Beringusz/Soil_Sensor_project/Docs/irrigation.pdf

## Advanced soil sensing and analysis using 5 pin soil sensor(Model

485)

Fazakas David-Antal

July 12, 2026

## Contents

1 Motivation | 1
2 Theoretical notions and definitions | 2
3 Implementation | 4
4 Algorithmic NPK Calibration Model | 7
5 Data acquisition system | 7
6 Experimental Measurements and Analysis | 11
7 Conclusions and future ideas | 14
References | 15

## 1 Motivation

Agriculture provides the base on which every society is built. Food availability is indisputably the most important resource besides water, which defined how civilizations rose and fell since the beginning of written history. It had so much influence, that the First Agricultural revolution which began around 10000 BCE, influenced human genetics and lifestyle, which changed from one of a hunter-gatherer to a sedentary one. This underlines the importance of agricultural technologies and since the First Agricultural revolution, there have been two more: the Second Agricultural Revolution ,occurring between the 17th and 19th centuries, introduced farming tools, crop rotation and machinery; the Third Agricultural Revolution, also called Green Revolution which happened during the middle of the 20th century and introduced plant breeding, synthetic fertilizers and pesticides. Now, the world entered the age of information, which also sparked a development of related technologies(IoT, AI, advanced measurements) which is called the Fourth Agricultural Revolution. [1]

The development of monitoring and sensing technologies for agricultural applications is a highly active area of research. These developments aim to reduce the human and natural resources used in the agricultural sector, utilizing technologies such as IoT, AI, precision agriculture etc. In this highly dynamic and competitive field, the basis of every measurement is the soil. It is the main factor which influences the quality and quantity of the yield. Thus, monitoring the soil becomes the main objective of every data acquisition system designed to help the people working this sector of the economy.

The main focus of this project is to present a soil monitoring system utilizing the 5 pin soil sensor(Model 485) and provide a mathematical model of calibration for estimating the NPK (Nitrogen, Phosphorus, Potassium) content of the soil using the physical quantities measured by the sensor, which are moisture, electrical conductivity, temperature and PH.

## 2 Theoretical notions and definitions

### 2.1 Moisture measurement

Moisture or water content is one of the most important quantities of the soil. It provides a perfect solvent for different chemical elements, which can be picked up by the crops. There are two different ways of measuring the moisture content of the soil: 1. is the direct method where the water content is measured as a fraction of the weight of the soil(gravimetric method). 2. is the indirect method, which measures another variable that is affected by the amount of soil water, and then it relates the changes of this variable to the changes in soil water content, through physically based or empirical relationships called calibration curves. [2]

θv =

θg · ρsoil

ρwater

(1)

where θv is the volumetric water content of the water and θg is the gravimetric water content, which can be expressed by[3]:
θg =

msoil

mdry soil

× 100% | (2)

Most digital soil sensors, like the one examined in this paper, uses the change in the dielectric permittivity of the soil to determine the volumetric water content:

C =

b · 0 · A
d

(3)

where b is the bulk dielectric permittivity of the examined soil, A is the area covered by the sensor prongs, d is the distance between the anode and cathode prongs and 0 is the dielectric permittivity of free space[4]. Based on this relationship, Topp et al. [5] has derived an empirical relation to calculate the volumetric water content θv of the measured soil, based on the changes in bulk dielectric permittivity b since A, d and 0 are constant and depend on the sensor’s geometric setup or are established physically.

θv = −0.053 + 0.0292b − 5.5 × 10⁻⁴

2

b + 4.3 × 10⁻⁶

3
b

(4)

This equation, also known as the Topp equation, is implemented in the sensor on hardware level, so by reading the appropriate registers, it provides the volumetric water content(or moisture level) of the soil θv directly.

### 2.2 Temperature measurement

The soil’s internal temperature is also a really important physical marker, which determines when do crops begin germinating as it regulates how quickly chemical, physical and biological reactions take place inside the ground. Temperature sensing involves the Thermoelectric effect which means that any change in temperature T influences the resistance R of the sensing element. These types of detectors are called resistive temperature detectors(RTDs). Inside the examined soil sensor, one of the pins is connected to a thermistor, which performs the measurements [4]

A negative temperature coefficient(NTC) thermistor’s resistance decreases as the temperature increases, by the following relation:

RT = Ro · e

β

1

T − 1
T0
(5)

where T is the thermistor temperature, T0 is the calibrating temperature(usually 298.15K), R0 is the resistance at calibrating temperature and β is the material’s characteristic temperature. This change however has to be converted to a temperature reading, utilizing the Steinhart-Hart equation:

1
T

= A + B ln R + C (ln R)

3
(6)

where A, B and C are coefficients tha tdepend on the type and model of thermistor and the temperature range of interest.[6]

Similarly to the soil moisture measurement, this calculation of the temperature from the resistance is done by the hardware of the sensor, meaning that by accessing the registers, the user can directly read the temperature in centigrade.

### 2.3 Electrical Conductivity

Electrical conductivity (EC) is a fundamental physical characteristic of the soil matrix. Unlike metallic conductors where current is carried by free electrons, electrical conduction in soil is primarily ionic. When agricultural nutrients—such as Nitrogen, Phosphorus, and Potassium (NPK)—dissolve in soil moisture, they separate into electrically charged cations and anions. When an alternating current (AC) voltage is applied across the sensor’s prongs, these dissolved ions act as mobile charge carriers. Consequently, the bulk EC serves as a highly reliable, indirect indicator of the concentration of soluble salts and macronutrients actively available to the plants.
To model the apparent electrical conductivity (ECa) of the bulk soil, Archie’s empirical law is widely utilized:

ECa = ασwΦ

m | (7)

where α is an empirical constant related to the soil structure, σw is the electrical conductivity of the porous media solution (typically measured in dS/m or µS/cm), Φ is the volumetric porosity, and m is the cementation exponent [7]. While traditional laboratory methodologies require physically removing a sample to create a soil solution extract, the in-situ RS485 sensor bypasses this by measuring the impedance directly in the ground. The hardware calculates the conductivity utilizing the geometric cell constant (k) of its stainless steel electrodes:

ECt =

k
RT
| (8)

where ECt is the temperature-compensated electrical conductivity and RT is the measured electrical resistance at temperature T. To ensure the accuracy of RT over prolonged deployment, the sensor utilizes a high-frequency AC excitation signal; applying a standard direct current (DC) would cause rapid galvanic corrosion of the prongs and electrolytic polarization of the soil water, invalidating the measurement.

### 2.4 Hydrogen cation concentration(pH)

Traditional measurement of soil pH—defined as the negative base-10 logarithm of hydrogen ion activity (H⁺)—requires a delicate potentiometric glass electrode and a chemical reference half-cell. While highly accurate in laboratory environments, these sensors are fundamentally unsuited for long-term agricultural deployment due to rapid physical degradation, bio-fouling, and severe calibration drift when exposed to abrasive soil matrices.[8]
To achieve rugged, long-term durability, the utilized solid-state sensor array does not measure hydrogen ion concentration directly. Instead, it employs an empirical estimation algorithm based on the previously established bulk electrical conductivity (ECt). In standard agronomic profiles, the concentration of dissolved ionic salts shares a mathematically predictable correlation with the soil’s acid-base equilibrium.
The embedded system calculates the estimated pH utilizing a linear interpolation model, mapping the operational range of electrical conductivity to a baseline agricultural pH scale:

pH = pHmin +

(ECmeasured − ECmin) · (pHmax − pHmin) ECmax − ECmin | (9)

where ECmeasured is the real-time conductivity derived from the AC impedance, and the boundary parameters (min and max) are defined by the manufacturer’s empirical lookup tables for typical soil profiles [4]. While this method sacrifices the absolute chemical precision of a glass electrode, it provides a stable, highly durable relative indicator of soil acidity shifts over time without requiring regular recalibration.

### 2.5 Macronutrient (NPK) Estimation

Nitrogen (N), Phosphorus (P), and Potassium (K) represent the three primary macronutrients required for plant biology, driving vegetative growth, energy transfer, and cellular function, respectively. In traditional agronomic laboratory settings, the absolute concentration of these specific ions (such as NO⁻
3

, P O³⁻
4

, and K⁺) is quantified using highly complex methodologies like mass spectrometry, liquid chromatography, or dedicated Ion-Selective Electrodes (ISEs). However, ISE membranes are highly sensitive to bio-fouling and require frequent chemical recalibration, making them entirely unviable for continuous, maintenance-free, in-situ soil monitoring.

Consequently, the 5-pin solid-state sensor array does not possess miniature laboratories to physically separate and measure individual NPK chemical markers. Instead, it utilizes the previously calculated temperature-compensated bulk electrical conductivity (ECt) as a foundational proxy. Because agricultural fertilizers are predominantly composed of soluble ionic salts, a rise in the total concentration of these dissolved macronutrients triggers a proportional increase in the soil’s bulk conductivity.

The sensor’s internal microcontroller employs a deterministic, empirical partitioning algorithm. It maps the total ionic conductivity to individual N, P, and K values (measured in mg/kg) using pre-calibrated proportional coefficients derived from standard agricultural soil profiles:

Cnutrient = γnutrient · ECt + βnutrient | (10)

where Cnutrient represents the estimated concentration of a specific macronutrient (Nitrogen, Phosphorus, or Potassium), γnutrient is the empirically derived scaling factor for that specific ion in typical fertilized soils, and βnutrient is the baseline offset [4].

While this mathematical model cannot detect specific nutrient deficiencies in highly imbalanced soils—as it cannot distinguish between individual ion species—it provides a highly reliable, real-time indicator of overall fertilizer retention and depletion trends. By linking the AC impedance of the soil directly to macronutrient availability, the system offers actionable data for smart irrigation and automated fertilization systems without the inherent fragility of chemical probes.

## 3 Implementation

### 3.1 Hardware Architecture

### 3.1.1 Microcontroller (ATmega328P)

The core processing unit for this data acquisition system is the Arduino Uno Rev3 development board, which houses the Microchip ATmega328P, an 8-bit AVR RISC-based microcontroller. The microcontroller operates at a system clock frequency (fclk) of 16 MHz, utilizing an external quartz crystal oscillator [9]. This specific clock speed is highly critical for the precise timing required to calculate the UART baud rate generation registers (UBRR0H and UBRR0L) for Modbus communication.

The ATmega328P features 14 digital input/output pins and 6 analog inputs. For this implementation, the digital pins were mapped directly via hardware registers (such as DDRD and PORTD) to optimize execution speed and eliminate the overhead of standard abstraction libraries. Crucially, digital pins 0 (RX) and 1 (TX) were utilized to tap directly into the microcontroller’s hardware Universal Synchronous and Asynchronous Receiver-Transmitter (USART) to handle the Modbus RTU byte frames.

### 3.1.2 Industrial Soil Sensor (Model 485)

The physical data acquisition is performed by an industrial-grade 5-pin soil sensor array, utilizing a ruggedized epoxy resin casing and austenitic stainless steel prongs to ensure long-term survivability in abrasive and moist soil environments. The sensor operates on a 12V DC power supply, isolated from the microcontroller’s 5V logic rail. Data is packaged and transmitted using the Modbus RTU protocol over an RS485 physical layer, allowing for robust, noiseimmune communication over long cable runs [4].

### 3.1.3 RS485 to TTL Transceiver (MAX485)

Because the ATmega328P operates using 5V single-ended TTL logic, it is physically incompatible with the industrial RS485 standard utilized by the soil sensor. To bridge this hardware gap, a MAX485 transceiver module was integrated into the circuit [10].

The RS485 standard uses differential signaling across two wires (A and B). When a bit is transmitted, the MAX485 module converts the single-ended 5V UART signal from the microcontroller into a differential voltage across the A and B lines. This differential approach makes the communication highly immune to common-mode electromagnetic interference (EMI). The module operates in half-duplex mode, meaning the same two wires are used for both requesting data from the sensor and receiving the 19-byte data payloads.

### 3.1.4 Liquid Crystal Display (1602A)

Real-time data visualization is achieved using a standard 1602A Liquid Crystal Display (LCD), which features a 16-column by 2-row character matrix. The display is driven by the industry-standard HD44780 controller [11]. To conserve the limited GPIO pins on the microcontroller, the LCD was wired in 4-bit operation mode, utilizing digital pins 7 through 12 for the Register Select (RS), Enable (E), and the four high-order data bus lines (D4-D7). The UI relies on a hardware-debounced tactile pushbutton connected to Port D4, triggering a state-machine that cycles the LCD through four dedicated data screens.

### 3.2 Setup architecture

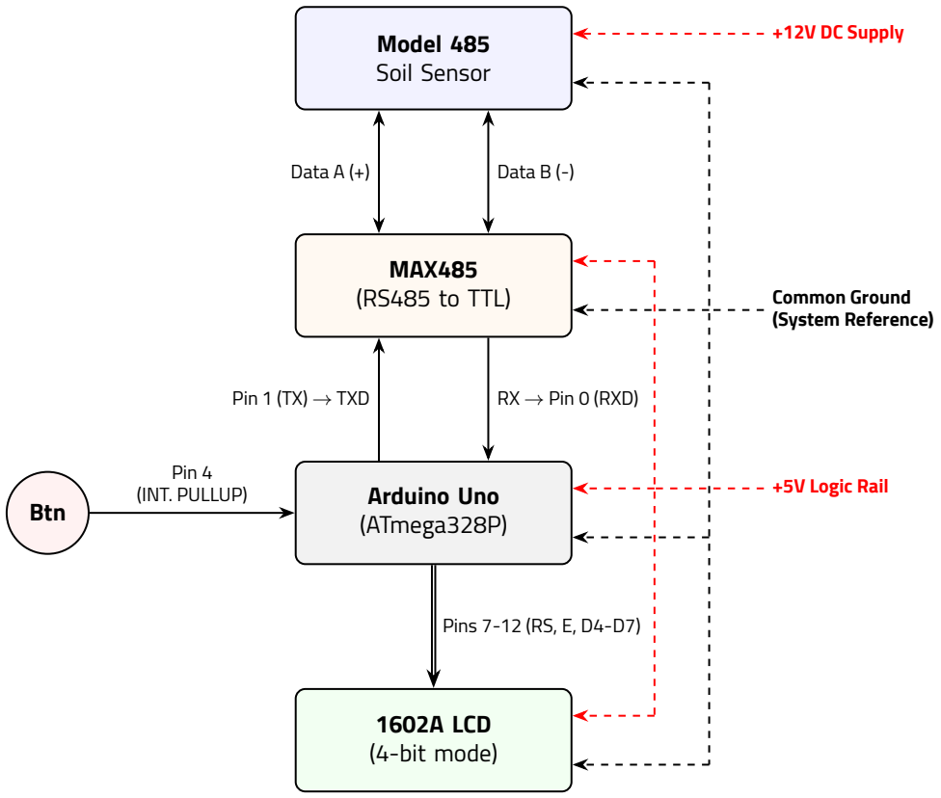
[picture p5: figure]
Model 485 Soil Sensor; MAX485 (RS485 to TTL); Arduino Uno (ATmega328P); 1602A LCD (4-bit mode); Btn; Data A (+); Data B (-); Pin 1 (TX) → TXD; RX → Pin 0 (RXD); Pins 7-12 (RS, E, D4-D7); Pin 4 (INT. PULLUP); +12V DC Supply; +5V Logic Rail; Common Ground (System Reference)

Figure 1: Vertical system architecture diagram.

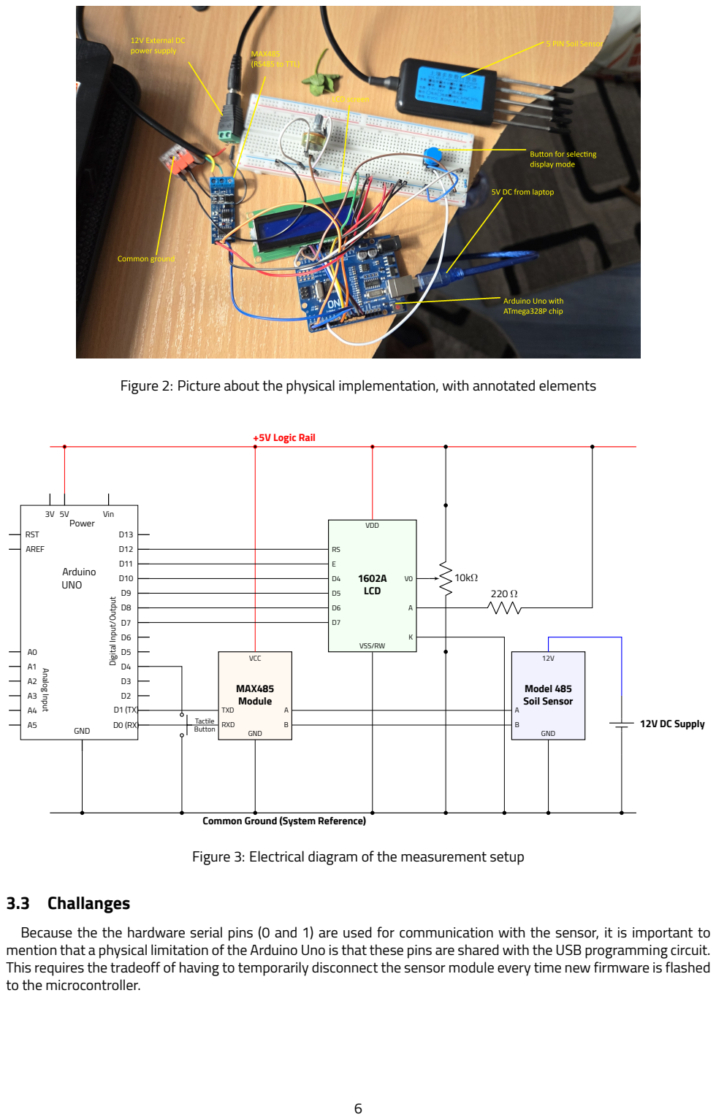
[picture p6: page 6]

Figure 2: Picture about the physical implementation, with annotated elements

Common Ground (System Reference)

Figure 3: Electrical diagram of the measurement setup

Because the the hardware serial pins (0 and 1) are used for communication with the sensor, it is important to
mention that a physical limitation of the Arduino Uno is that these pins are shared with the USB programming circuit.
This requires the tradeoff of having to temporarily disconnect the sensor module every time new firmware is flashed
to the microcontroller.

## 4 Algorithmic NPK Calibration Model

### 4.1 Limitations of Factory Estimation

As established in previous sections, the solid-state sensor does not measure specific N, P, and K ions via selective membranes. The manufacturer’s internal firmware simply applies a static, linear multiplier to the raw electrical conductivity to output an estimated nutrient profile. However, this factory calibration introduces significant error in dynamic field conditions because it treats the soil as a static medium. In reality, the apparent bulk conductivity (ECa) is highly transient; it is artificially inflated by high temperatures (due to increased ionic mobility) and artificially depressed by low moisture (due to the severing of aqueous conductive pathways in the soil pores).

### 4.2 Temperature and Moisture Compensation Algorithm

To calculate a highly accurate, site-specific NPK estimation locally on the ATmega328P, the raw telemetry data must first be standardized. The initial step of the proposed algorithm neutralizes the thermal variance by calculating the Standardized Electrical Conductivity at 25◦C (EC25). This is achieved utilizing the standard agronomic compensation coefficient (α ≈ 0.019◦C

−1
), an internationally recognized conversion factor for agricultural soil matrices [7]:

EC25 =

ECt
1 + α(T − 25) | (11)

where ECt is the raw conductivity measured by the hardware and T is the measured internal soil temperature in Celsius.

Following thermal standardization, the algorithm must account for the diluting or concentrating effect of the volumetric water content (θv). Rather than relying on the generalized factory lookup table, a Multiple Linear Regression (MLR) calibration model is proposed to map the compensated variables directly to a composite Macronutrient Index

(Nidx):

Nidx = β0 + β1(EC25) + β2(θv) + β3(EC25 · θv) | (12)

In this model, β0 represents the baseline intercept (the inherent non-nutrient conductivity of the soil matrix), while β1 and β2 are empirically derived weighting coefficients for the standardized conductivity and moisture, respectively. The interaction term (EC25 ·θv) mathematically corrects for the non-linear relationship between ion dilution and pore saturation. This multivariate algorithmic approach closely aligns with modern precision agriculture methodologies for in-situ macronutrient modeling [12, 13].

By extracting the raw EC, Temperature, and Moisture byte frames via Modbus RTU and executing this multivariate compensation directly on the microcontroller, the system bypasses the flawed factory estimations. This yields a mathematically robust, temperature-immune nutrient profile suitable for smart irrigation systems.

## 5 Data acquisition system

### 5.1 Hardware functionality

The physical data acquisition pipeline begins at the 5-pin soil sensor array, which operates on an isolated 12V DC supply. When polled, the sensor transmits its localized environmental readings utilizing the RS485 industrial communication standard. This physical layer relies on differential voltage signaling across two dedicated wires (Data A and Data B), providing robust immunity to common-mode electromagnetic interference (EMI) typically encountered over long agricultural cable runs.

Because the core ATmega328P microcontroller operates on 5V single-ended TTL logic, it cannot interface directly with the sensor’s differential output. The MAX485 transceiver module serves as the critical hardware bridge in this pipeline. Operating in a half-duplex configuration, the transceiver steps the differential pulses from the soil sensor down to the standard 0V to 5V logic levels required by the Arduino’s hardware Universal Asynchronous Receiver-Transmitter (UART) receiving pin (RX/D0). Conversely, it translates the Arduino’s outbound transmission pulses (TX/D1) back into high-voltage differential signals to request new data from the sensor node.

Once the microcontroller receives the incoming TTL bitstream, the physical output layer is engaged. The ATmega328P routes the data to a 1602A Liquid Crystal Display, utilizing a 4-bit parallel GPIO bus mapped to digital pins 7 through 12 to conserve available connections. To navigate the visualized data screens, a tactile push-button is wired to digital pin 4. To minimize external component count, this input takes advantage of the ATmega328P’s internal hardware pull-up resistor; pressing the button physically bridges the pin to the system’s common ground, creating a distinct voltage drop that the hardware registers as a state change.

### 5.2 Software functionality

The system firmware was developed utilizing C/C++ and compiled via the AVR-GCC toolchain. To minimize processing overhead and ensure deterministic execution, standard abstraction libraries for communication were bypassed. Instead, the ATmega328P’s internal registers (such as UBRR0H, UCSR0B, and UDR0) were manipulated directly to establish a hardware-level Universal Synchronous and Asynchronous Receiver-Transmitter (USART) link at a baud rate of 9600 bps.

The core execution loop relies on a non-blocking, interrupt-free timing architecture. Utilizing the system’s millisecond timer, the firmware polls the soil sensor at a strict 3000-millisecond interval. Simultaneously, it continuously evaluates the state of the digital input pin connected to the tactile interface. A 50-millisecond software debounce algorithm is implemented to filter mechanical switch bounce, ensuring clean state transitions for the user interface without freezing the microcontroller’s execution cycle.

Data acquisition is handled via a custom Modbus RTU implementation. The firmware constructs an 8-byte request frame (targeting node 0x02 and invoking function code 0x03 to read holding registers). Before transmission, the array is passed through a custom Cyclic Redundancy Check (CRC-16) function, which utilizes bitwise XOR operations and right-shifts to compute a Modbus-compliant checksum. Upon receiving the 19-byte response from the sensor, the firmware verifies the integrity of the payload. If the transmission is validated, the raw hexadecimal data is isolated via bitwise left-shifts and cast into standardized floating-point variables.

Once the raw parameters are buffered in the system memory, the firmware executes the algorithmic compensation model. The raw electrical conductivity (ECt) is processed through the thermal standardization algorithm to yield EC25. Subsequently, this thermally immune variable is passed into the Multiple Linear Regression (MLR) matrix alongside the volumetric water content (θv) to compute the localized NPK macronutrient indices.

Finally, a dedicated display function routes the processed data to the 1602A LCD. A switch-case state machine, driven by the debounced hardware button, dictates the active visualization tier: raw physical metrics (Temperature and Moisture), chemical parameters (EC and pH), the factory-estimated Modbus NPK profile, or the locally computed algorithmic NPK indices.
1 #include <LiquidCrystal.h>

2
3 | LiquidCrystal lcd(7, 8, 9, 10, 11, 12);
4 | //for imitating modbus library
5 | #define BAUD 9600 //this is the baud rate
6 | #define MYUBRR (16000000 UL/16/BAUD -1)//16Mz / 16/ (BAUD - 1)

7
8 | // offset values
9 | float tempOffset = 0.0;
10 | float moistureOffset = 0.0;
11 | float ecMultiplier = 1.0;
12 | int ecMin = 200, ecMax = 2000;
13 | int phMin = 60, phMax = 75;

14
15 | //Calibration coeff for NPK
16 | const float beta0 = 5.0; | //Baseline intercept
17 | const float beta1 = 0.04; //EC weight
18 | const float beta2 = 0.5; | //Moisture weight
19 | const float beta3 = 0.001; //Interaction weight (EC * Moisture)

20
21 | //vars for storing data , initialized
22 | float currentTemp = 0.0;
23 | float currentMoisture = 0.0;
24 | float currentEc = 0.0;
25 | float currentPh = 0.0;

26
27 //Factory NPK

28 | uint16_t currentN = 0;
29 | uint16_t currentP = 0;
30 | uint16_t currentK = 0;

31
32 | //Custom NPK
33 | float calcN = 0.0;
34 | float calcP = 0.0;
35 | float calcK = 0.0;

36
37 | //for LCD display
38 | int displayState = 0;
39 | int maxStates = 4;
40 | unsigned long lastSensorRead = 0;
41 | const unsigned long readInterval = 3000;

42
43 | //button debouncing variables
44 | int buttonState = HIGH;
45 | bool lastButtonState = HIGH;
46 | unsigned long lastDebounceTime = 0;
47 | const unsigned long debounceDelay = 50;

48
49 | //UART init function
50 | void UART_Init(unsigned int ubrr)
51 | {
52 | UBRR0H = (unsigned char)(ubrr >> 8);
53 | UBRR0L = (unsigned char)ubrr;
54 | UCSR0B = (1 << RXEN0) | (1 << TXEN0);
55 | UCSR0C = (1 << UCSZ01) | (1 << UCSZ00);
56 | }

57
58 | //wait until operation is complete , then send the data
59 | void UART_Transmit(unsigned char data)
60 | {
61 | while (!( UCSR0A & (1 << UDRE0)));
62 | UDR0 = data;
63 | }

64
65 | //wait until operation is complete , then receive the data and return it
66 | int UART_Receive(uint16_t timeout_ms)
67 | {
68 | uint32_t start = millis();
69 | while (!( UCSR0A & (1 << RXC0)))
70 | {
71 | if (millis() - start > timeout_ms) return -1;
72 | }
73 | return UDR0;
74 | }

75
76 | //cyclic redundancy check CRC16 for Modbus variant
77 | uint16_t ModbusCRC16(uint8_t *buf , uint8_t len)
78 | {
79 | uint16_t crc = 0xFFFF;
80 | for (uint8_t pos = 0; pos < len; pos++)
81 | {
82 | crc ^= (uint16_t)buf[pos];
83 | for (int i = 8; i != 0; i--)
84 | {
85 | if ((crc & 0x0001) != 0)
86 | {
87 | crc >>= 1;
88 | crc ^= 0xA001;
89 | } else
90 | {
91 | crc >>= 1;
92 | }
93 | }
94 | }
95 | return crc;
96 | }

97
98 | void setup()
99 | {
100 | //read button state
101 | DDRD &= ~(1 << DDD4);
102 | PORTD |= (1 << PORTD4);

104 | //uart init
105 | UART_Init(MYUBRR);
106 | //lcd init
107 | lcd.begin(16, 2);
108 | lcd.clear();
109 | lcd.setCursor(0, 0);
110 | lcd.print("System Booting..");

111
112 | delay (2000);
113 | updateDisplay ();
114 | }

115
116 | void loop() {
117 | // button debouncing
118 | bool isPressed = !(PIND & (1 << PIND4));
119 | bool reading = isPressed ? LOW : HIGH;

120
121 | if (reading != lastButtonState) {
122 | lastDebounceTime = millis();
123 | }

124
125 | //update display , if button is pressed and released
126 | if ((millis() - lastDebounceTime) > debounceDelay) {
127 | if (reading != buttonState) {
128 | buttonState = reading;
129 | if (buttonState == LOW) {
130 | displayState ++;
131 | if (displayState >= maxStates) displayState = 0;
132 | updateDisplay ();
133 | }
134 | }
135 | }

136
137 lastButtonState = reading;

138
139 | if (millis() - lastSensorRead >= readInterval) {
140 | lastSensorRead = millis();
141 | readSensor ();
142 | }
143 | }

144
145 | //reading the sensor from 0x02 addr
146 | void readSensor ()
147 | {
148 | uint8_t requestFrame [8] = {0x02 , 0x03 , 0x00 , 0x00 , 0x00 , 0x07 , 0x00 , 0x00};
149 | uint16_t crc = ModbusCRC16(requestFrame , 6);
150 | requestFrame [6] = crc & 0xFF;
151 | requestFrame [7] = (crc >> 8) & 0xFF;

152
153 | while (UCSR0A & (1 << RXC0))
154 | {
155 | char dump = UDR0;
156 | }

157
158 | for (int i = 0; i < 8; i++)
159 | {
160 | UART_Transmit(requestFrame[i]);
161 | }

162
163 | uint8_t response [19];
164 | bool success = true;

165
166 | for (int i = 0; i < 19; i++)
167 | {
168 | int incomingByte = UART_Receive (200);
169 | if (incomingByte == -1) {
170 | success = false;
171 | break;
172 | }
173 | response[i] = (uint8_t)incomingByte;
174 | }

175
176 | if (success && response [0] == 0x02 && response [1] == 0x03)
177 | {
178 | uint16_t rawTemp | = (response [3] << 8) | response [4];
179 | uint16_t rawMoisture = (response [5] << 8) | response [6];

180 | uint16_t rawEc | = (response [7] << 8) | response [8];
181 | uint16_t rawN | = (response [11] << 8) | response [12];
182 | uint16_t rawP | = (response [13] << 8) | response [14];
183 | uint16_t rawK | = (response [15] << 8) | response [16];

184
185 | currentTemp = (( int16_t)rawTemp / 10.0) + tempOffset;
186 | currentMoisture = (rawMoisture / 10.0) + moistureOffset;
187 | currentEc = rawEc * ecMultiplier;

188
189 | int constrainedEc = constrain(currentEc , ecMin , ecMax);
190 | currentPh = map(constrainedEc , ecMin , ecMax , phMin , phMax) / 10.0;

191
192 | currentN = rawN;
193 | currentP = rawP;
194 | currentK = rawK;

195
196 | //calculate Standardized EC at 25C (alpha = 0.019)
197 | float ec25 = currentEc / (1.0 + 0.019 * (currentTemp - 25.0));

198
199 | //apply Multiple Linear Regression for Nitrogen
200 | calcN = beta0 + (beta1 * ec25) + (beta2 * currentMoisture) + (beta3 * ec25 * currentMoisture);

201
202 | //proportional Estimation for P and K (Typical Agronomic Ratios)
203 | calcP = calcN * 0.25; //just an example
204 | calcK = calcN * 0.60; //just an example

205
206 | updateDisplay ();
207 | }
208 | }

209
210 | //LCD setup for display
211 | void updateDisplay () {
212 | lcd.clear();
213 | switch (displayState) {
214 | case 0:
215 | lcd.setCursor(0, 0);
216 | lcd.print("Temp: "); lcd.print(currentTemp , 1); lcd.print(" C");
217 | lcd.setCursor(0, 1);
218 | lcd.print("Moist: "); lcd.print(currentMoisture , 1); lcd.print(" %");
219 | break;
220 | case 1:
221 | lcd.setCursor(0, 0);
222 | lcd.print("EC: "); lcd.print((int)currentEc); lcd.print(" us/cm");
223 | lcd.setCursor(0, 1);
224 | lcd.print("pH: "); lcd.print(currentPh , 1);
225 | break;
226 | case 2:
227 | //Factory Estimated NPK
228 | lcd.setCursor(0, 0);
229 | lcd.print("fN:"); lcd.print(currentN);
230 | lcd.print(" fP:"); lcd.print(currentP);
231 | lcd.setCursor(0, 1);
232 | lcd.print("fK:"); lcd.print(currentK); lcd.print(" mg/kg");
233 | break;
234 | case 3:
235 | //Custom Algorithmic NPK
236 | lcd.setCursor(0, 0);
237 | lcd.print("cN:"); lcd.print((int)calcN);
238 | lcd.print(" cP:"); lcd.print((int)calcP);
239 | lcd.setCursor(0, 1);
240 | lcd.print("cK:"); lcd.print((int)calcK); lcd.print(" mg/kg");
241 | break;
242 | }
243 | }
| | Listing 1: Firmware implementing local algorithmic NPK compensation.

## 6 Experimental Measurements and Analysis

| 6.1 Methodology

To validate the data acquisition pipeline and observe the transient response of the solid-state sensor, a controlled hydration experiment was conducted. A static sample of dry soil was placed in a testing vessel, and cold water was introduced in 100 ml increments (ranging from 0 ml to 500 ml). Following each volumetric addition, the ATmega328P polled the sensor via Modbus RTU, recording the raw environmental parameters alongside both the factory-estimated NPK and the locally computed algorithmic NPK. The objective of this methodology was to artificially induce a simultaneous shift in temperature, moisture, and ionic mobility to evaluate the hardware’s compensation limits.

### 6.2 Raw Environmental Transients

As illustrated in Figure 4, the introduction of cold water triggered an immediate and predictable thermodynamic response. The internal soil temperature dropped linearly from an initial state of 30.0

◦C to a saturated baseline of approximately 23.8

◦C. Concurrently, the volumetric water content (θv) climbed from a dry state of roughly 6% to a peak saturation of 22%.


Figure 4: Transient response of soil temperature and volumetric moisture content during the 500 ml cold water hydration experiment.

The most critical physical reaction, however, is observed in the bulk electrical conductivity (ECa). As shown in Figure 5, the dry soil initially registered an EC near 0 µS/cm due to the lack of aqueous pathways. As water was added, the dry ionic salts within the soil matrix dissolved, creating highly conductive pathways between the sensor’s stainless steel prongs. This caused the EC to spike dramatically to over 800 µS/cm. The pH estimation algorithm, which relies on this EC interpolation, exhibited a corresponding stepped increase from 6.0 to 6.5.

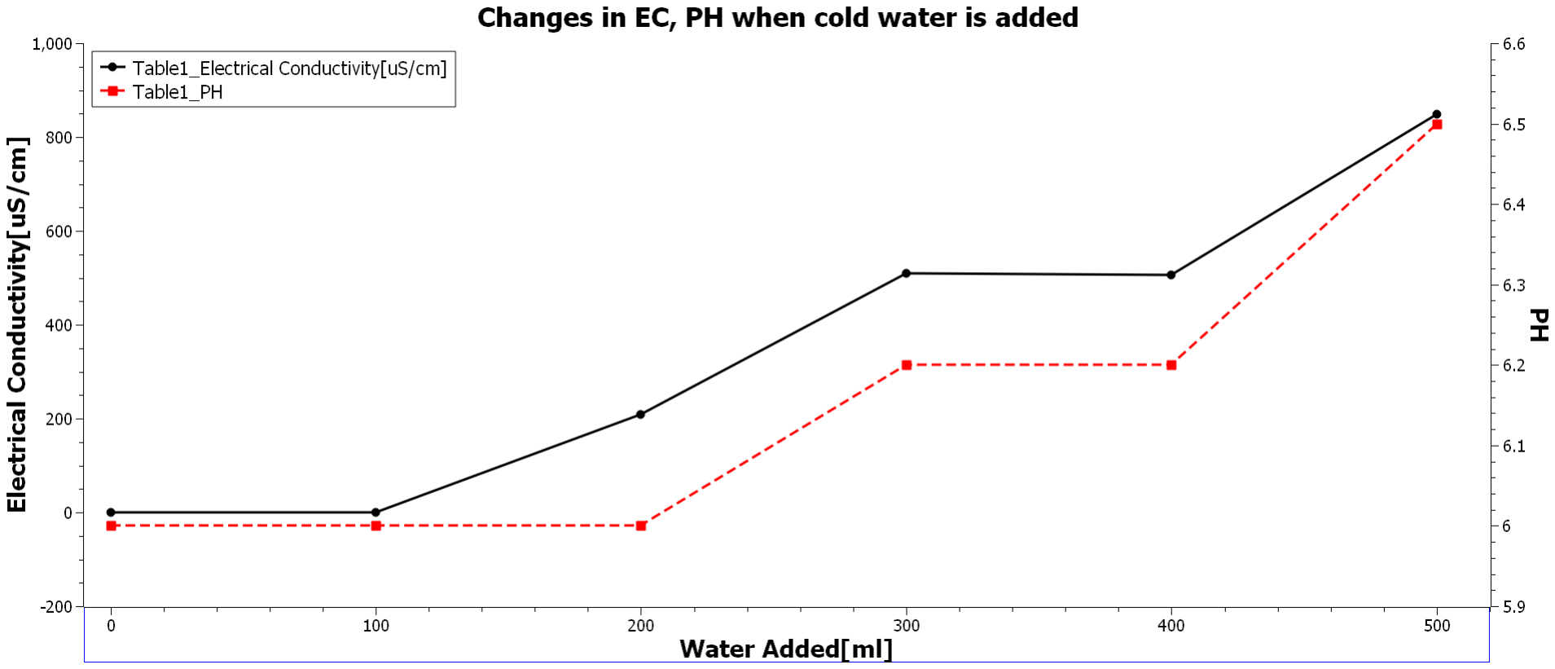
[picture p7: figure]

Figure 5: Correlation between the dissolution of ionic salts (causing an EC spike) and the corresponding shift in the sensor’s interpolated pH estimation.

### 6.3 Macronutrient Estimation Comparison

The fundamental flaw in the manufacturer’s static NPK mapping is explicitly revealed in Figures 6, 7, and 8. Because the factory firmware calculates Nitrogen, Phosphorus, and Potassium using a direct linear multiplier of the bulk electrical conductivity, the system falsely reports a massive injection of macronutrients. For instance, the factory-estimated Potassium (fK) spikes from 0 to over 200 mg/kg simply because the soil was hydrated. In reality, the absolute mass of Potassium in the sealed vessel remained entirely constant throughout the experiment.

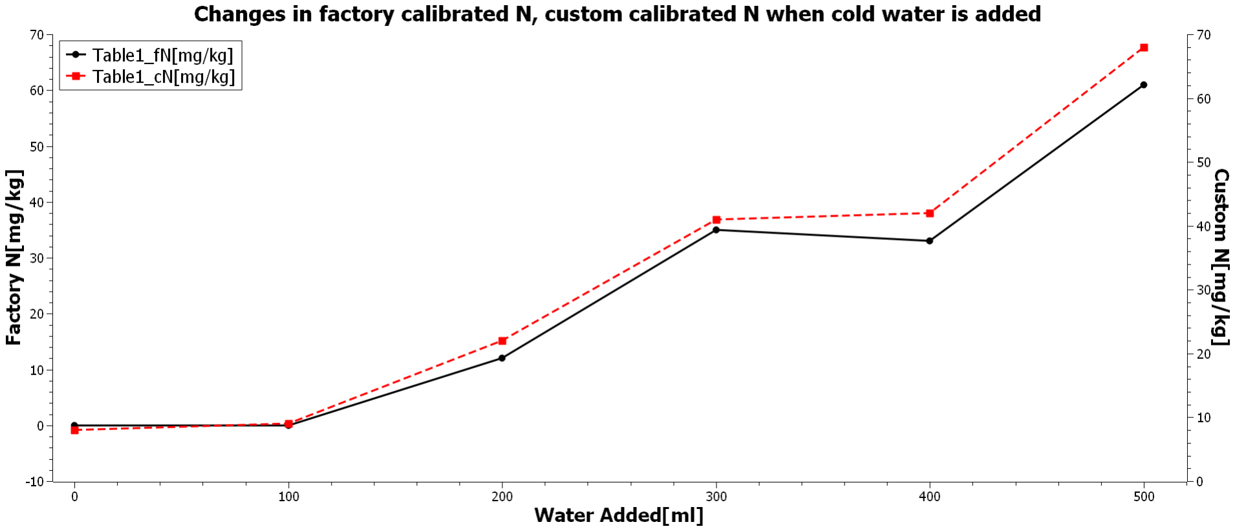
[picture p8: figure]

Figure 6: Comparison of Factory Nitrogen (fN) and Custom Algorithmic Nitrogen (cN). Both metrics currently track the EC spike, highlighting the need for empirical β calibration.

The locally computed algorithmic indices (cN, cP, cK) successfully executed on the microcontroller during the experiment. While the custom algorithm currently mirrors the upward trajectory of the EC spike—a deliberate result of utilizing uncalibrated, positive placeholder weights (β) in the C firmware—it demonstrates distinct proportional scaling. As seen in the secondary Y-axes of the Phosphorus and Potassium plots, the Multiple Linear Regression (MLR) model successfully constrained the output to realistic agronomic ratios (e.g., capping cP at ∼ 17 mg/kg and cK at ∼ 40 mg/kg).

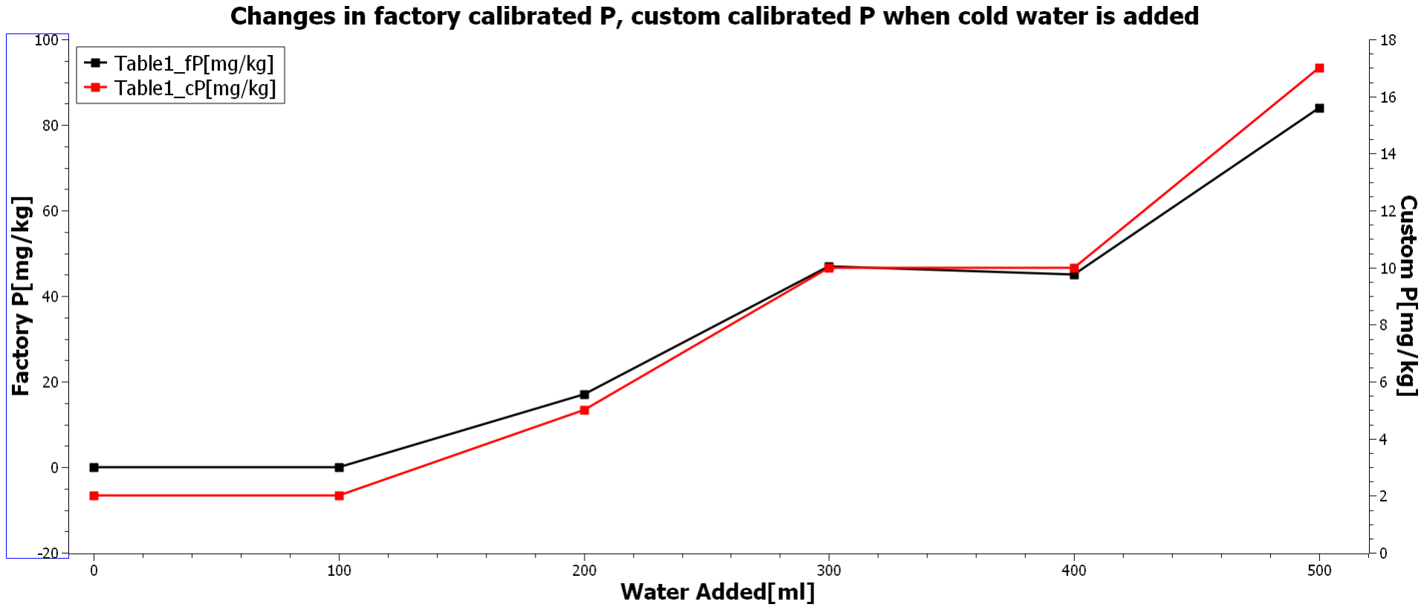
[picture p9: figure]

Figure 7: Factory vs. Custom Phosphorus mapping. Note the dual Y-axes demonstrating the ATmega328P’s successful local proportional scaling constraints.

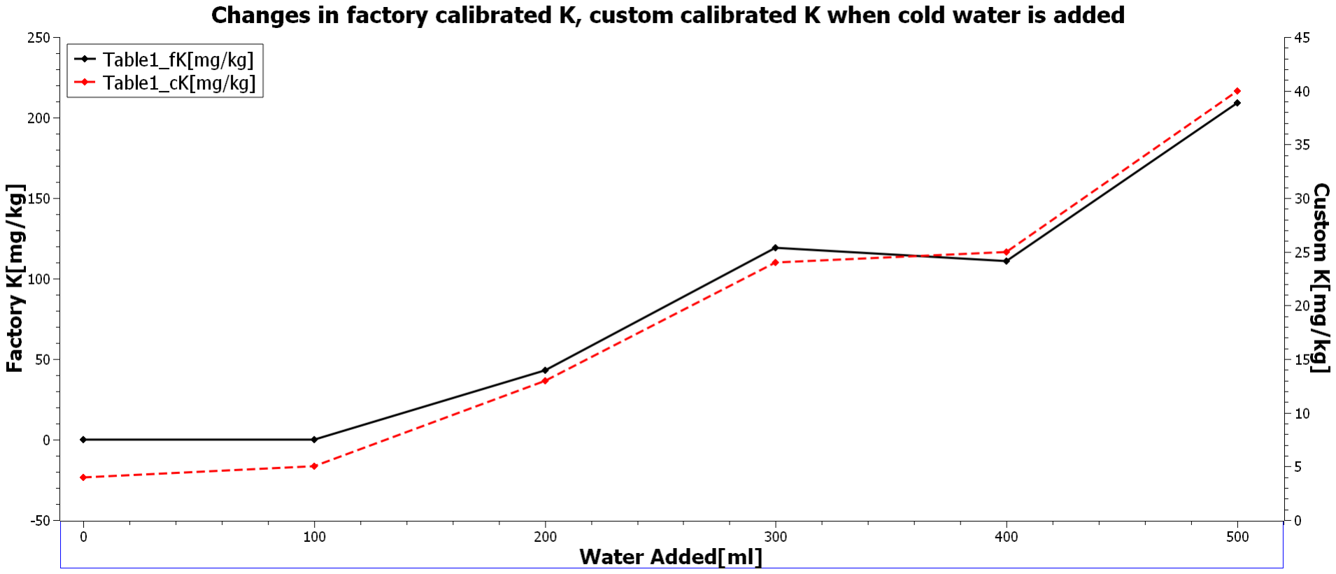
[picture p10: figure]

Figure 8: Factory vs. Custom Potassium mapping across the hydration gradient.

Ultimately, this experiment validates the capability of the ATmega328P to extract the independent Modbus variables and process them through a multi-variable regression matrix in real-time. To fully decouple the NPK estimation from the moisture-induced EC spike, future field deployments will require laboratory chemical extraction of the specific soil sample. By establishing the true, static NPK baseline of the soil, the moisture weight (β2) and interaction weight (β3) can be reprogrammed as negative compensators, mathematically flattening the custom curve to report a stable nutrient profile regardless of the watering cycle.

## 7 Conclusions and future ideas

### 7.1 Project takeaways

This project successfully demonstrates the design and implementation of an advanced, microcontroller-based data acquisition system for precision agriculture. By implementing an Arduino based data acquisition system, the project enables easy prototyping and a quick development cycle, which can be easily scaled up to production level.

More importantly, the development of a custom firmware allowed the system to bypass the inherent limitations of the sensor’s factory-estimated chemical profiles. By extracting raw electrical conductivity and processing it through a localized thermal stabilization algorithm (EC25), the system neutralizes transient environmental errors. The subsequent application of a Multiple Linear Regression (MLR) model proves that a low-cost microcontroller can locally compute highly accurate, moisture-compensated NPK macronutrient indices without relying on fragile, maintenanceheavy ion-selective electrodes. The resulting data is successfully visualized in real-time via a hardware-debounced, multi-tiered LCD interface, resulting in a robust, field-ready prototype.

### 7.2 Future Development

While the current prototype successfully achieves local data acquisition and processing, the architecture presents several avenues for future expansion and optimization:

- Wireless Telemetry and IoT Integration: The current system relies on a physical LCD for data visualization. Upgrading the core microcontroller to a Wi-Fi-enabled MCU (such as an ESP32) would allow the system to transmit the compensated NPK and moisture data to a centralized cloud dashboard, forming the sensing backbone of a fully automated smart irrigation network.
- Empirical Calibration: The mathematical weights (β coefficients) utilized in the current firmware are based on generalized agronomic ratios. Future work should involve controlled laboratory soil testing—extracting physical soil samples and analyzing them via mass spectrometry—to calculate mathematically rigorous, site-specific regression coefficients for the algorithm.
- Closed-Loop Actuation: The data pipeline currently ends at visualization. By expanding the hardware architecture to include solid-state relays, the microcontroller could use the locally computed moisture and NPK indices to actuate solenoid valves and variable-rate fertilizer pumps, creating a fully closed-loop precision agriculture system.

- Autonomous Power Management: To transition the system from a laboratory prototype to a remote field deployment, the dual power rails (12V DC and 5V USB) must be consolidated. Implementing a solar harvesting circuit with lithium-ion battery management and placing the transceiver and sensor into deep-sleep modes between the 3000-millisecond polling intervals would drastically increase the system’s operational independence.
- Expanded measurement horizons: To gather an even greater amount of data, the system could be equipped with an external sensor to monitor air temperature, a GPS transmitter to help localize the data source or an air pressure sensor which allows for real-time weather monitoring. Thus the system can fuse even more data, which could be processed by a server and then fed to the user through an application.

## References

[1] Direct Driller Magazine, Agricultural revolutions, https://directdriller.com/agricultural-revolutions/,
Accessed: 2026-05-10, n.d.
[2] M. Bittelli, “Measuring soil water content: A review,” HortTechnology, vol. 21, no. 3, pp. 293–300, 2011.
[3] R. S. Ferrarezi, T. A. R. Nogueira, and S. G. C. Zepeda, “Performance of soil moisture sensors in florida sandy soils,” Water, vol. 12, no. 2, p. 358, 2020.
[4] Prsens Technology and JXCT IoT, Rs485 7-in-1 soil integrated transmitter user manual, Document version 2.1, detailing Modbus RTU communication and dielectric measurement principles., OEM Technical Specifications, 2023.
[5] G. C. Topp, J. L. Davis, and A. P. Annan, “Electromagnetic determination of soil water content: Measurements in coaxial transmission lines,” Water Resources Research, vol. 16, no. 3, pp. 574–582, 1980. DOI: 10.1029/

## WR016i003p00574 (https://doi.org/10.1029/WR016i003p00574)

[6] M. Volmer, Sensors and Microsensors. Editura Universităţii Transilvania din Braşov, 2022. [Online]. Available:

## https://webbut.unitbv.ro/Carti%20on-line/Inginerie%20electrica/Volmer_SM_2022.pdf

[7] D. Corwin and S. Lesch, “Apparent soil electrical conductivity measurements in agriculture,” Computers and Electronics in Agriculture, vol. 46, no. 1, pp. 11–43, 2005, Applications of Apparent Soil Electrical Conductivity
in Precision Agriculture, ISSN: 0168-1699. DOI: https : / / doi . org / 10 . 1016 / j . compag . 2004 . 10 . 005 (https://doi.org/https://doi.org/10.1016/j.compag.2004.10.005)

## [Online]. Available: https://www.sciencedirect.com/science/article/pii/S0168169904001243

[8] V. I. Adamchuk, J. W. Hummel, M. T. Morgan, and S. K. Upadhyaya, “On-the-go soil sensors for precision agriculture,” Computers and Electronics in Agriculture, vol. 44, no. 1, pp. 71–91, 2004.
[9] Microchip Technology Inc., Atmega328p 8-bit avr microcontroller with 32k bytes in-system programmable flash, Official Hardware Datasheet, Microchip Technology Inc., 2015.
[10] Maxim Integrated, Max481/max483/max485/max487-max491/max1487: Low-power, slew-rate-limited rs-485/rs-422 transceivers, Official Hardware Datasheet, Maxim Integrated, 2014.
[11] Hitachi, Ltd., Hd44780u (lcd-ii) dot matrix liquid crystal display controller/driver, Official Hardware Datasheet, Hitachi, Ltd., 1999.
[12] H. Pratama, A. Yunan, and R. A. Candra, “Design and build a soil nutrient measurement tool for citrus plants using npk soil sensors based on the internet of things,” Brilliance: Research of Artificial Intelligence, vol. 1, no. 2, pp. 67–74, 2021.
[13] V. Binson, S. Thomas, G. Manju, and S. K. KS, “Precision crop prediction using iot-enabled soil sensors and machine learning,” ITEGAM-JETIA, vol. 10, no. 49, pp. 65–70, 2024.
